FastRabbit/hdlcSpy/hw/hdlcSpy/hdlcSpy.kicad_pcb

## KiCad design hw/hdlcSpy/hdlcSpy.kicad_pcb (2026-10-03)

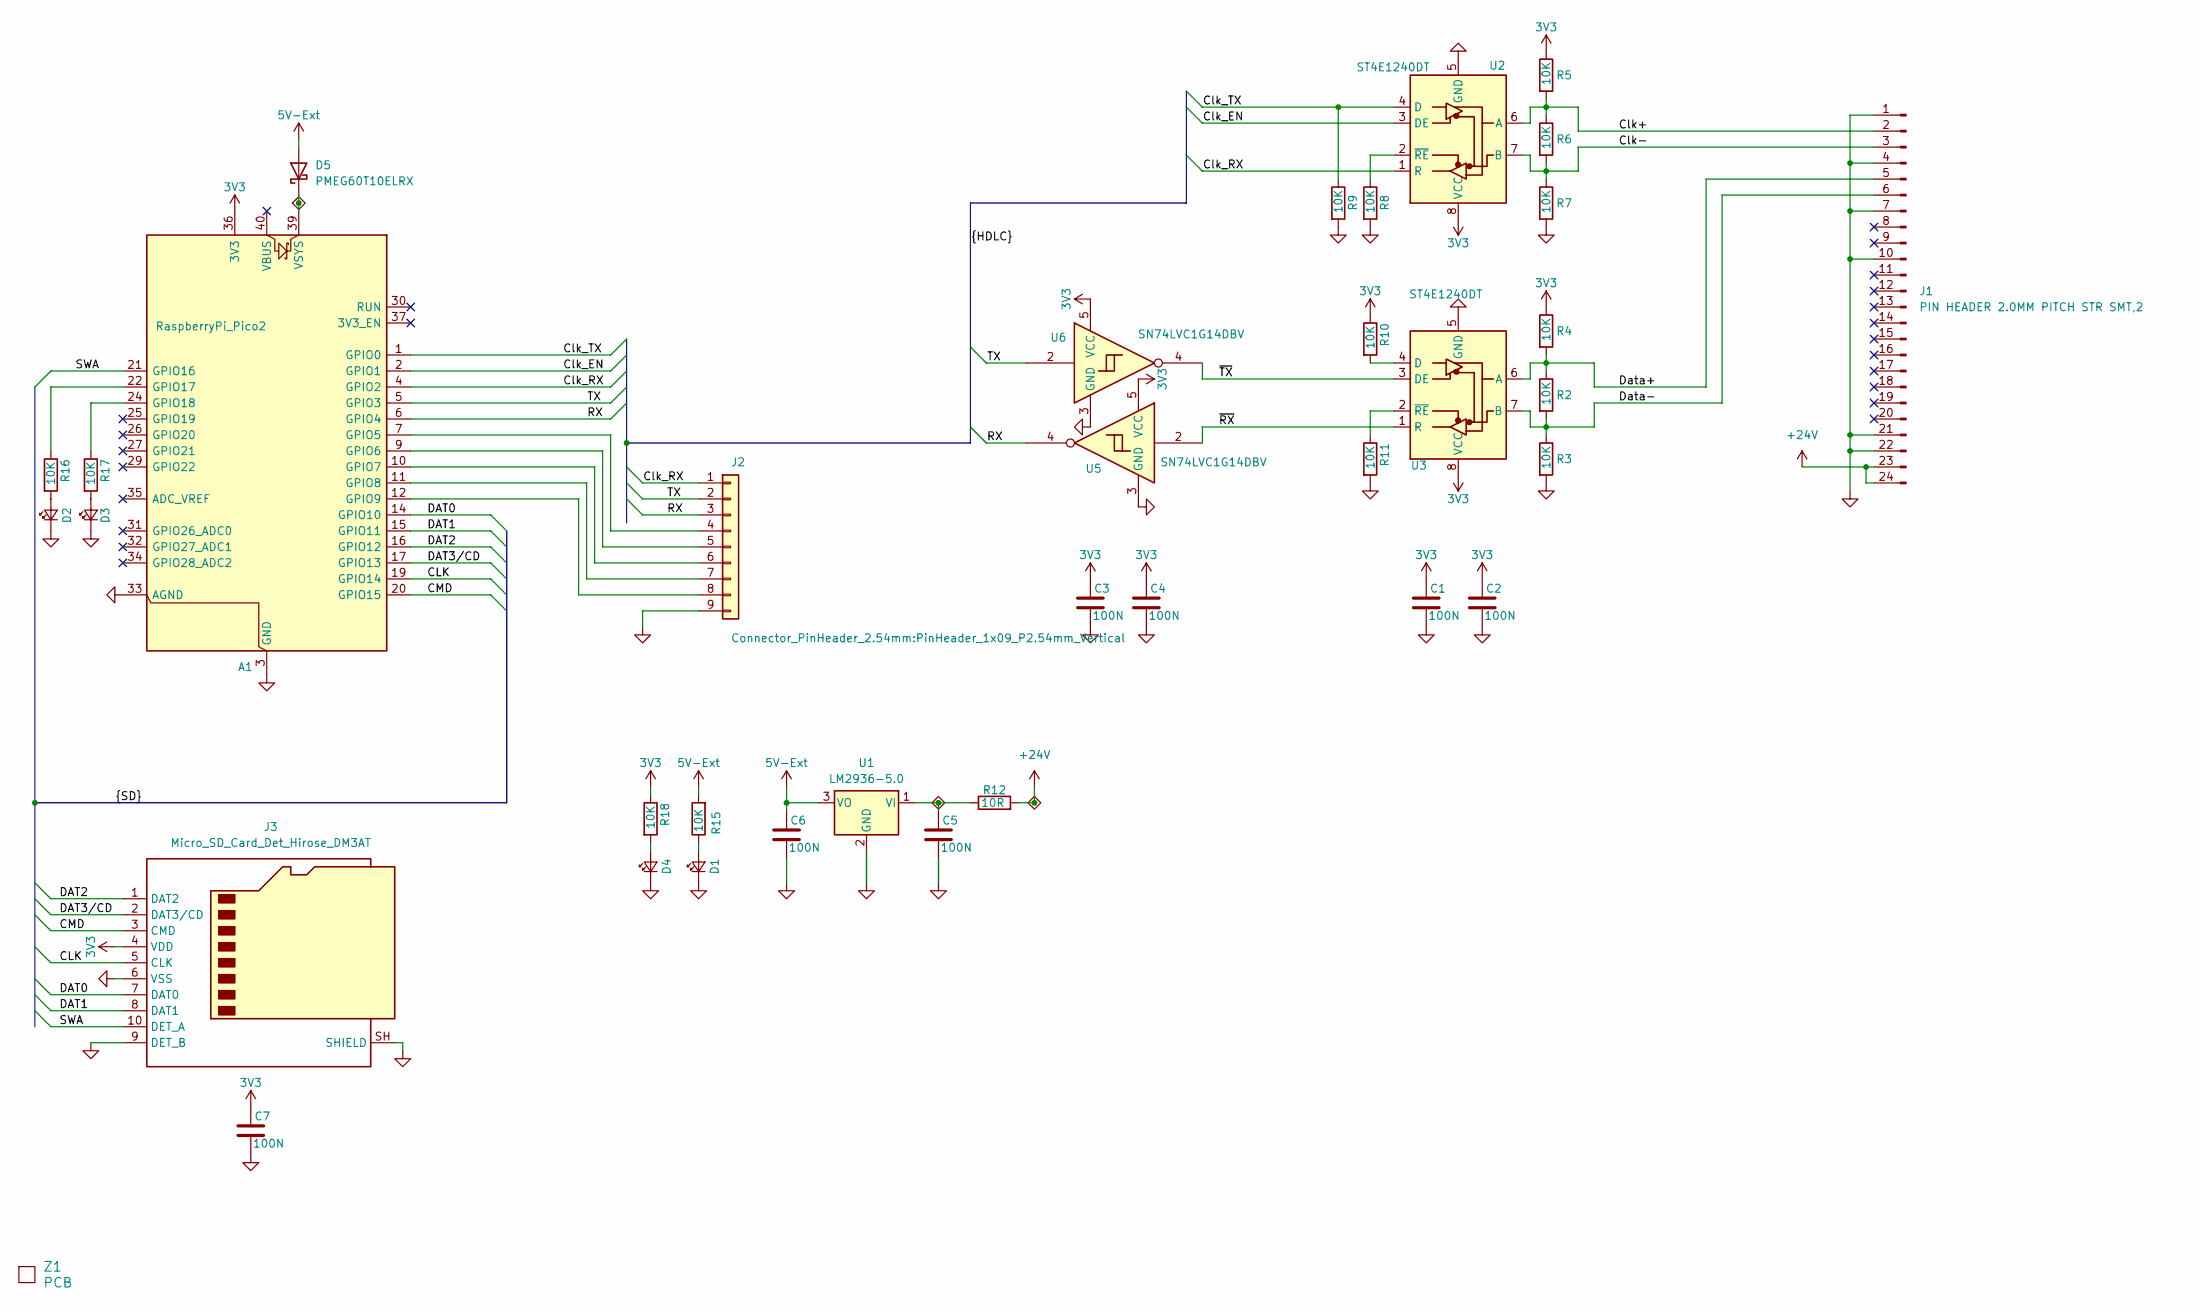
[picture p1: schematic hdlcSpy.kicad_sch, ${PROJECTNAME}]

Parts:
A1: RaspberryPi_Pico2; RaspberryPi_Pico_Common_Unspecified; DigiKey 2648-SC1631CT-ND
C1, C2, C3, C4, C5, C6, C7: 100N; C_0603_1608Metric_Pad1.08x0.95mm_HandSolder
D1, D2, D3, D4: VLMTG1400-GS08; LED_0603_1608Metric; DigiKey VLMTG1400-GS08CT-ND
D5: PMEG60T10ELRX; Nexperia_CFP3_SOD-123W; DigiKey 1727-7807-1-ND
J1: PIN HEADER 2.0MM PITCH STR SMT,2; G825M24401YEU; DigiKey 664-G825M24401YEUTR-ND
J2: Connector_PinHeader_2.54mm:PinHeader_1x09_P2.54mm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; PinHeader_1x09_P2.54mm_Vertical
J3: Micro_SD_Card_Det_Hirose_DM3AT; DM3CS-SF; Mouser 798-DM3D-SF
R2, R3, R4, R5, R6, R7, R8, R9, R10, R11, R15, R16, R17, R18: 10K; R_0603_1608Metric_Pad0.98x0.95mm_HandSolder
R12: 10R; R_0603_1608Metric_Pad0.98x0.95mm_HandSolder
U1: LM2936-5.0; SOT-223-3_TabPin2; DigiKey LM2936MP-5.0/NOPBCT-ND
U2, U3: ST4E1240DT; SOIC-8_3.9x4.9mm_P1.27mm; DigiKey 296-23802-1-ND
U5, U6: SN74LVC1G14DBV; SOT-23-5; DigiKey 296-11607-1-ND
Z1: PCB; 4L

Connections:
3V3: A1.36 (3V3), C1.1, C2.1, C3.1, C4.1, C7.1, J3.4 (VDD), R4.1, R5.1, R10.1, R18.1, U2.8 (VCC), U3.8 (VCC), U5.5 (VCC), U6.5 (VCC)
5V-Ext: C6.1, D5.2 (A), R15.2, U1.3 (VO)
+24V: J1.23, J1.24, R12.2
/CLK: A1.19 (GPIO14), J3.5 (CLK)
/CMD: A1.20 (GPIO15), J3.3 (CMD)
/Clk+: J1.2, R5.2, R6.1, U2.6 (A)
/Clk-: J1.3, R6.2, R7.1, U2.7 (B)
/Clk_EN: A1.2 (GPIO1), U2.3 (DE)
/Clk_RX: A1.4 (GPIO2), J2.1, U2.1 (R)
/Clk_TX: A1.1 (GPIO0), R9.1, U2.4 (D)
/DAT0: A1.14 (GPIO10), J3.7 (DAT0)
/DAT1: A1.15 (GPIO11), J3.8 (DAT1)
/DAT2: A1.16 (GPIO12), J3.1 (DAT2)
/DAT3/CD: A1.17 (GPIO13), J3.2 (DAT3/CD)
/Data+: J1.5, R2.1, R4.2, U3.6 (A)
/Data-: J1.6, R2.2, R3.1, U3.7 (B)
/RX: A1.6 (GPIO4), J2.3, U5.4
/SWA: A1.21 (GPIO16), J3.10 (DET_A)
/TX: A1.5 (GPIO3), J2.2, U6.2
/~RX: U3.1 (R), U5.2
/~TX: U3.3 (DE), U6.4
GND: A1.3 (GND), A1.8 (GND), A1.13 (GND), A1.18 (GND), A1.23 (GND), A1.28 (GND), A1.33 (AGND), A1.38 (GND), C1.2, C2.2, C3.2, C4.2, C5.2, C6.2, C7.2, D1.1 (K), D2.1 (K), D3.1 (K), D4.1 (K), J1.1, J1.4, J1.7, J1.10, J1.21, J1.22, J2.9, J3.6 (VSS), J3.9 (DET_B), J3.SH (SHIELD), R3.2, R7.2, R8.2, R9.2, R11.2, U1.2 (GND), U2.5 (GND), U3.5 (GND), U5.3 (GND), U6.3 (GND)
unnamed: A1.7 (GPIO5), J2.4
unnamed: A1.9 (GPIO6), J2.5
unnamed: A1.10 (GPIO7), J2.6
unnamed: A1.11 (GPIO8), J2.7
unnamed: A1.12 (GPIO9), J2.8
unnamed: A1.22 (GPIO17), R16.1
unnamed: A1.24 (GPIO18), R17.1
unnamed: A1.39 (VSYS), D5.1 (K)
unnamed: D1.2 (A), R15.1
unnamed: D2.2 (A), R16.2
unnamed: D3.2 (A), R17.2
unnamed: D4.2 (A), R18.2
unnamed: C5.1, R12.1, U1.1 (VI)
unnamed: R8.1, U2.2 (~RE)
unnamed: R10.2, U3.4 (D)
unnamed: R11.1, U3.2 (~RE)

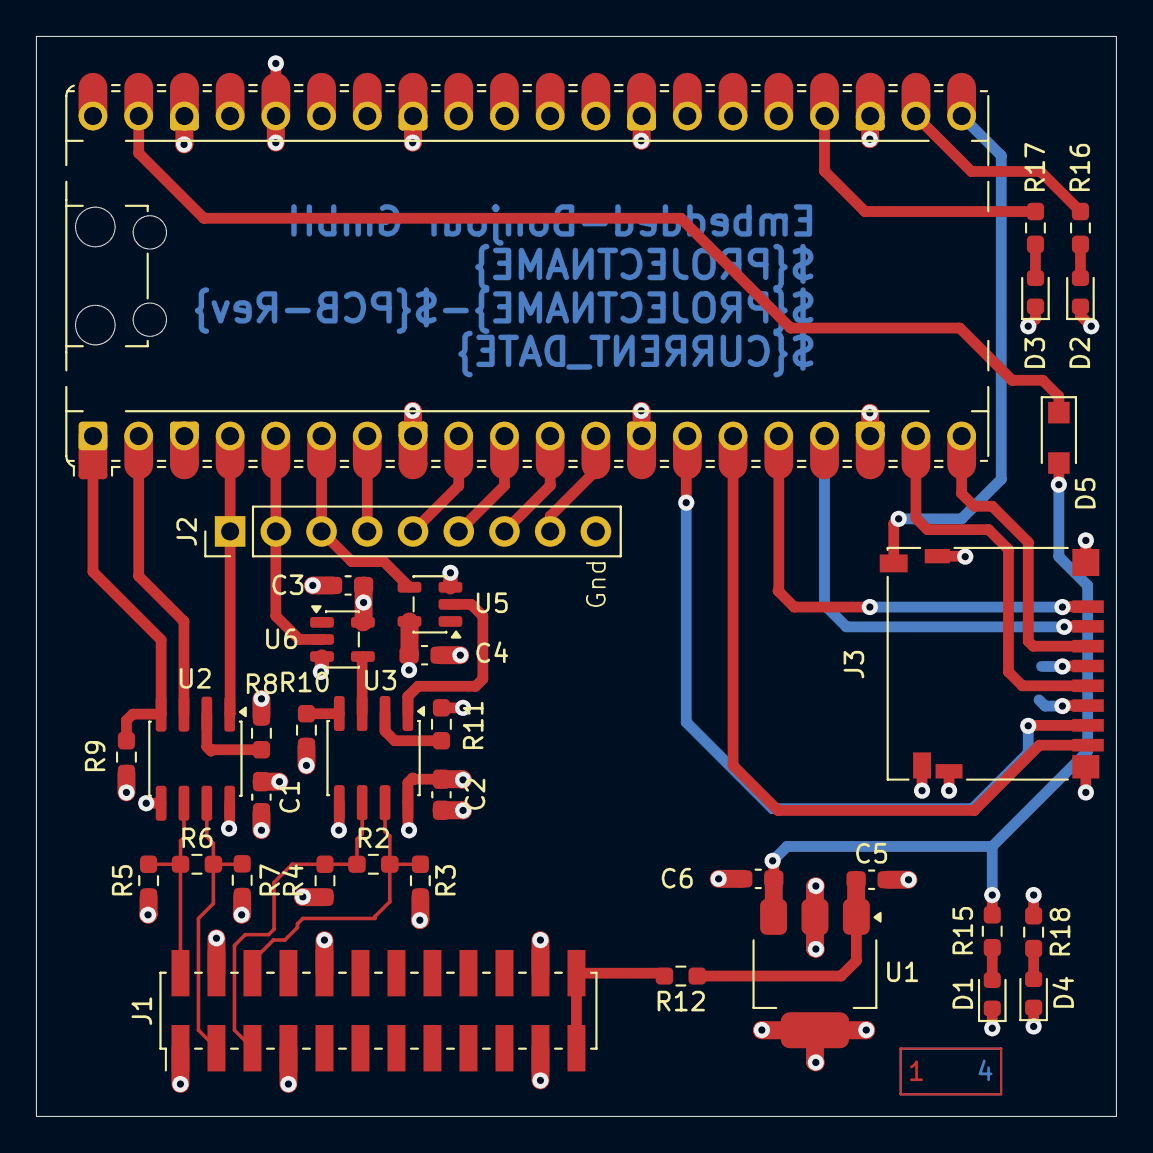
[picture p2: board hdlcSpy.kicad_pcb from above]

Board: 4 copper layers, 60.0 x 60.0 mm, 37 parts (1 on the bottom side), 38 nets.
