FastRabbit/hdlcSpy/(commit log)

2026-09-30 feat: add hw files
    [hdlcSpy.kicad_pcb, hdlcSpy.kicad_sch]
2026-10-01 feat: cleanup schematic and pcb
    [hdlcSpy.kicad_pcb, hdlcSpy.kicad_sch]
2026-10-02 feat: add sdcard to hw
    [hdlcSpy.kicad_sch]
2026-10-02 feat: sch and pcb done
    Add some Datasheets
    [hdlcSpy.kicad_pcb, hdlcSpy.kicad_sch]
2026-10-03 feat: orderd at Jjlcpcb
    [hdlcSpy.kicad_pcb, hdlcSpy.kicad_sch]
2026-10-05 feat: add Pico 2 firmware scaffold under fw/
    Add Pico SDK-based firmware project targeting the Raspberry Pi Pico 2
    (RP2350). Console I/O is exposed over USB CDC (no physical UART for
    stdio). Vendors the Pico SDK as a git submodule at fw/pico-sdk with the
    nested submodules it needs (tinyusb, mbedtls, cyw43-driver, btstack,
    lwip).
2026-10-05 feat(fw): print banner on USB CDC connect
    Print an ASCII banner once stdio_usb_connected() is true, before
    entering the counter loop, so a host terminal attaching to the USB
    CDC serial port sees a clear ready indicator.
2026-10-05 feat(fw): integrate clipilot CLI over USB CDC
    Vendor the clipilot CLI library (github.com/FastRabbit/clipilot) as a
    git submodule at fw/clipilot, and wire it into hdlcspy_fw as the
    console on the existing USB CDC stdio link.
    - fw/CMakeLists.txt: add_subdirectory(clipilot) with its own
    tests/examples disabled, link clipilot::clipilot into hdlcspy_fw.
    - fw/src/main.c: replace the counter loop with cli_init()/cli_poll(),
    using getchar_timeout_us()/putchar_raw() as the non-blocking
    getc/putc hooks. The console is (re)initialized whenever
    stdio_usb_connected() transitions to true, so a terminal attached
    after boot still gets the banner and a prompt.
    Only the built-in commands (help, h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
    [main.c]
2026-10-05 chore(fw): move submodules under fw/external/
    Move fw/pico-sdk -> fw/external/pico-sdk and fw/clipilot ->
    fw/external/clipilot to keep vendored third-party dependencies
    grouped separately from our own sources.
    Update the CMakeLists.txt add_subdirectory path, README build and init
    instructions, and the fw-builder agent notes accordingly.
    Verified: cmake configure and ninja build succeed against the new
    paths, hdlcspy_fw.uf2 is produced.
2026-10-05 fw: add LED driver and clipilot led command
    Drive 3 LEDs (onboard led0, led1=GPIO17, led2=GPIO18) from a
    non-blocking state machine (fw/src/led.c/.h) ticked every main-loop
    iteration so patterns keep running even without a host attached.
    Adds a clipilot `led` command with subcommands on/off/blink-slow
    (~1 Hz)/blink-fast (~5 Hz)/traffic (irregular router-activity-style
    flicker using pico_rand), each taking an optional led0/led1/led2/all
    selector defaulting to all. Links pico_rand for the traffic mode.
2026-10-05 fw: move led cli command into led.c/led.h
    Encapsulate the led subcommand handlers and the led cli_cmd_t table
    inside led.c, exposed via a single led_cli_command. main.c now just
    plugs it into the console config instead of owning LED-specific CLI
    code.
2026-10-05 fw: assemble app_commands from a module registry
    clipilot requires cli_config_t::commands to point at one contiguous
    array, so per-module cli_cmd_t singletons (like led_cli_command) can't
    be referenced directly by pointer when there is more than one. Add a
    small app_command_sources[] list that is copied into a real
    app_commands[] array at startup; adding a future module's command is
    then a one-line addition to that list, with no other wiring needed.
2026-10-05 docs: update agents and capture session lessons learned
    - fw-builder: note stale-submodule-path recovery, board header macros
    (PICO_DEFAULT_LED_PIN etc.), pico_rand-style extra link libs, and the
    new fw-cli-module scaffold for new console commands.
    - fw-reviewer: fix stale fw/pico-sdk path reference (now
    fw/external/pico-sdk), add a check for the clipilot command-module
    pattern vs hand-written tables in main.c.
    - New fw-cli-module agent: documents the led_cli_command pattern
    (one module, one cli_cmd_t singleton, one line in
    app_command_sources[]) so future commands follow it, and explains why
    the registry runtime-copy step is required instead of a static
    initializer list.
    - C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
2026-10-05 docs: add .github/instructions and .github/skills for fw/
    Mirrors the structure the clipilot submodule just added upstream
    (.github/instructions/*.instructions.md, .github/skills/*/SKILL.md),
    adapted to this repo and its actual history instead of copied:
    - instructions/git-workflow: branch, commit, PR and cleanup
    conventions actually used in this repo (gh CLI PR fallback,
    merge-commit style, submodule-move via git mv, checkpoint ref
    cleanup).
    - instructions/c-style: conventions in fw/src (non-blocking handlers,
    static command tables, board header macros, naming).
    - skills/fw-architecture: module map, hard invariants, the
    app_commands registry recipe for adding a console command, a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
2026-10-05 docs: start project documentation under doc/
    Add doc/README.md, doc/architecture.md, doc/hardware.md, and
    doc/firmware.md: repo layout, the CLI command registry pattern, a
    starting hardware component index derived from hw/datasheets, and a
    user-facing console/LED command reference. Cross-reference doc/ from
    CONTRIBUTING.md.
2026-10-05 feat(fw): add TX clock enable and signal driver and tx-clock command
    Adds fw/src/tx_clock.c/h: a GPIO1 enable line and a GPIO0 PWM-based
    clock signal (1kHz..1MHz, 50 percent duty), following the module/
    cli_cmd_t singleton pattern used by led.c. Wires it into main.c's
    command registry and links hardware_pwm/hardware_clocks.
    New tx-clock console command:
    tx-clock enable/disable drive/release GPIO1
    tx-clock on/off start/stop the GPIO0 PWM signal
    tx-clock frequency <hz> set frequency, clamped to 1kHz..1MHz
    tx-clock status show enable/output/frequency state
    Documents the new command and pin mapping in fw/README.md and
    doc/firmware.md, doc/hardware.md, doc/archit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
2026-10-05 refactor(fw): group tx_clock module state into one struct
    Replaces the five separate static variables (enable flag, output flag,
    frequency, PWM slice, PWM channel) in tx_clock.c with a single static
    tx_clock_state_t instance, so the module's mutable state reads as one
    unit instead of scattered globals. No behavior change.
    Configured, built, and confirmed hdlcspy_fw.uf2 is produced before
    removing the build directory.
    [tx_clock.c]
2026-10-06 feat(fw): add tx-clock invert subcommand
    Adds tx_clock_set_inverted()/tx_clock_is_inverted() to tx_clock.c/h,
    backed by pwm_set_output_polarity() on the clock signal's PWM channel
    (GPIO0). Takes effect immediately whether or not the output is
    currently running, matching the existing frequency command.
    New subcommand:
    tx-clock invert <on|off> flip the clock signal polarity
    status now also reports invert state. Documents the new subcommand in
    fw/README.md and doc/firmware.md.
    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
    [tx_clock.c, tx_clock.h]
